soldernerd/UserInterface/UserInterface_RevB_BOM.xlsx

Qty | Value | Device | Package | Parts | Description
5 | 0R | RESISTORR0805 | R0805 | R4, R5, R6, R23, R24 | RESISTOR, European symbol
1 | 10R | RESISTORR0805 | R0805 | R8 | RESISTOR, European symbol
3 | 100k | RESISTORR0805 | R0805 | R16, R17, R18 | RESISTOR, European symbol
4 | 100n | CC0805 | C0805 | C2, C14, C15, C16 | Capacitor
7 | 10k | RESISTORR0805 | R0805 | R2, R3, R7, R9, R10, R11, R12 | RESISTOR, European symbol
3 | 10n | CC0805 | C0805 | C11, C12, C13 | Capacitor
2 | 10u | CC0805 | C0805 | C1, C10 | Capacitor
7 | 1u | CC0805 | C0805 | C3, C4, C5, C6, C7, C8, C9 | Capacitor
3 | 22k | RESISTORR0805 | R0805 | R13, R14, R15 | RESISTOR, European symbol
7 | 680k | RESISTORR0805 | R0805 | R1, R19, R20, R21, R22, R25, R26 | RESISTOR, European symbol
1 | 74HC126 | 74HC126 | SO14 | IC2 | Quad buffer/line driver; 3-state
1 | MCP4641 | MCP4641 | TSSOP14 | IC1 | Dual DigiPot with 128 steps and non-volatile memory
1 | MCP601R | MCP601R | SOT-23-5 | IC4 | Rail-to-Rail OpAmp (Marking SM07)
1 | MIDAS MCCOG42005A6W | LCD4X20_I2C | LCD_4X20_I2C | DISPLAY | 4x20 character LCD display with I2C interface
1 | NTR4101PT1G | P-FETSOT23 | SOT23 | Q2 | P-Channel MOSFET (Marking TR4)
1 | NX3008NBK | N-FETSOT23 | SOT23 | Q1 | N-Channel MOSFET (Marking KS)
1 | PEC11R | ENCODER_BOURNS | ENCODER_BOURNS | ENCODER | Bourns Rotary Encoder with Switch
