soldernerd/UserInterface/UserInterface_RevA_Schematic.pdf

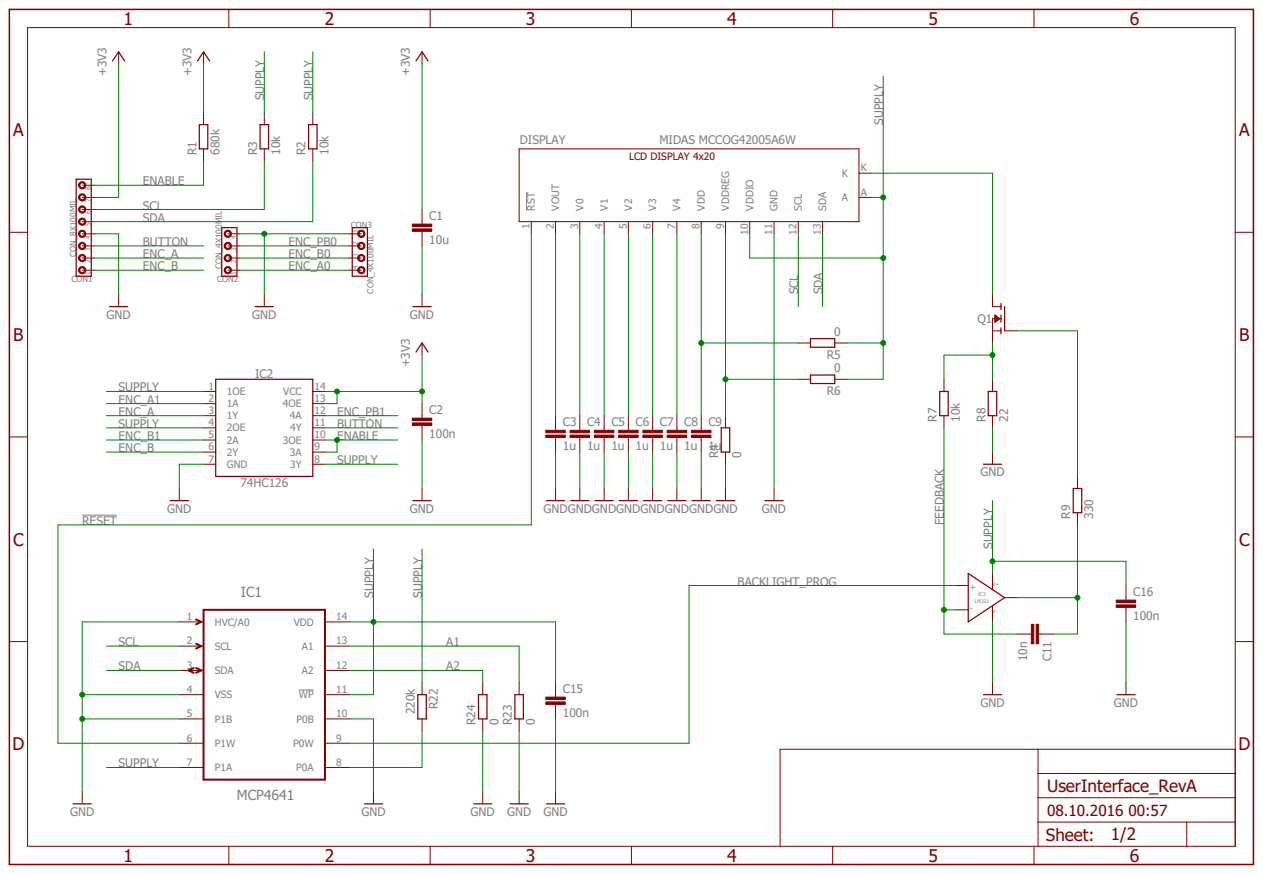
[picture p1: page 1]
