soldernerd/UserInterface/UserInterface_RevA_Board.pdf

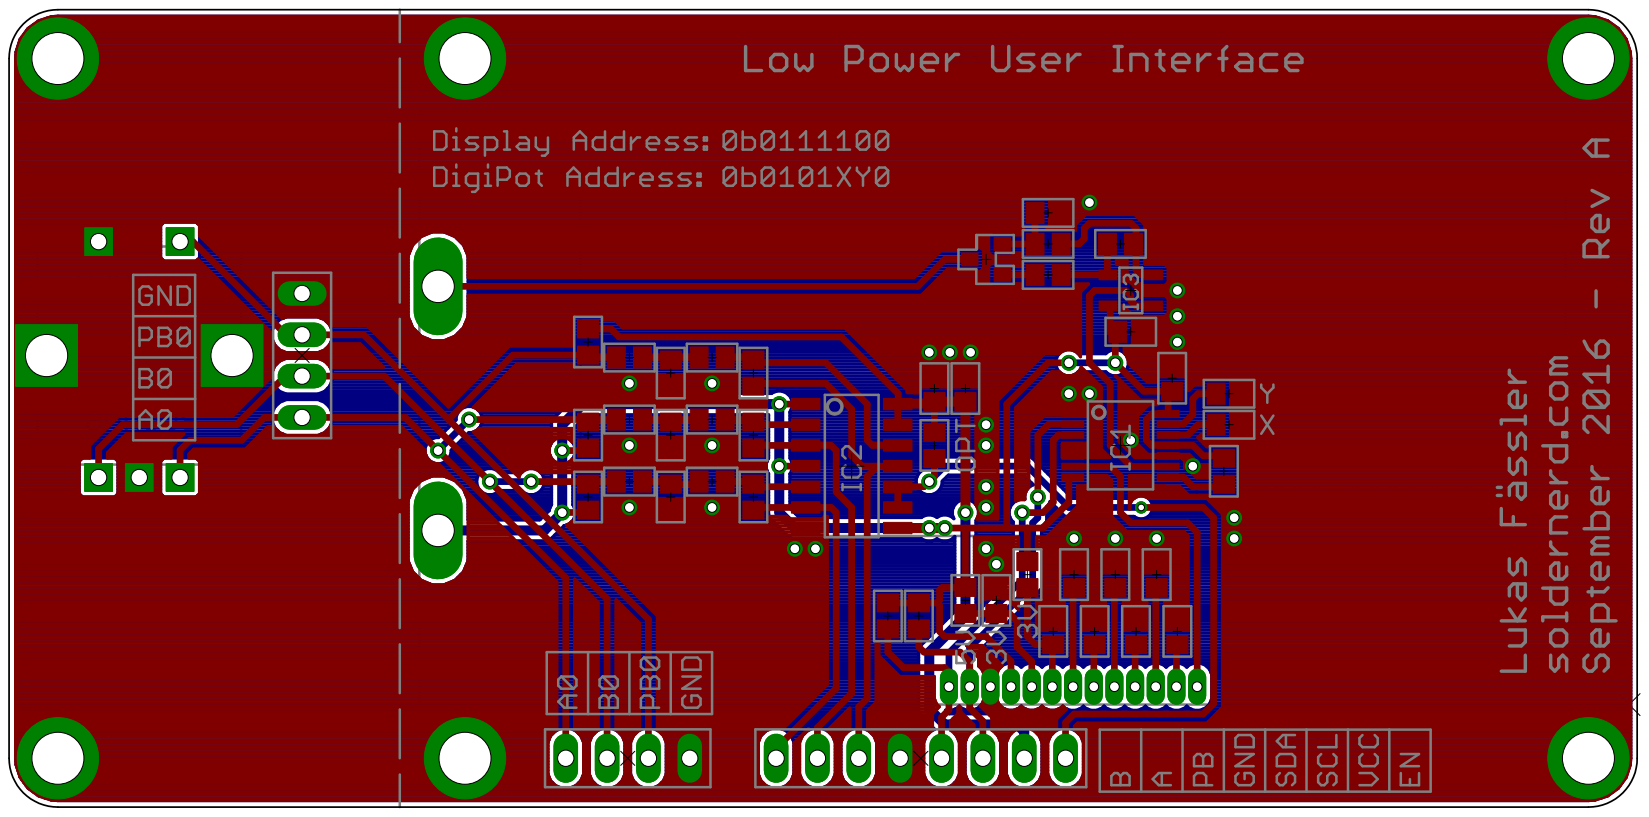
[picture p2: page 1]
