soldernerd/UserInterface/UserInterface_RevB.pdf

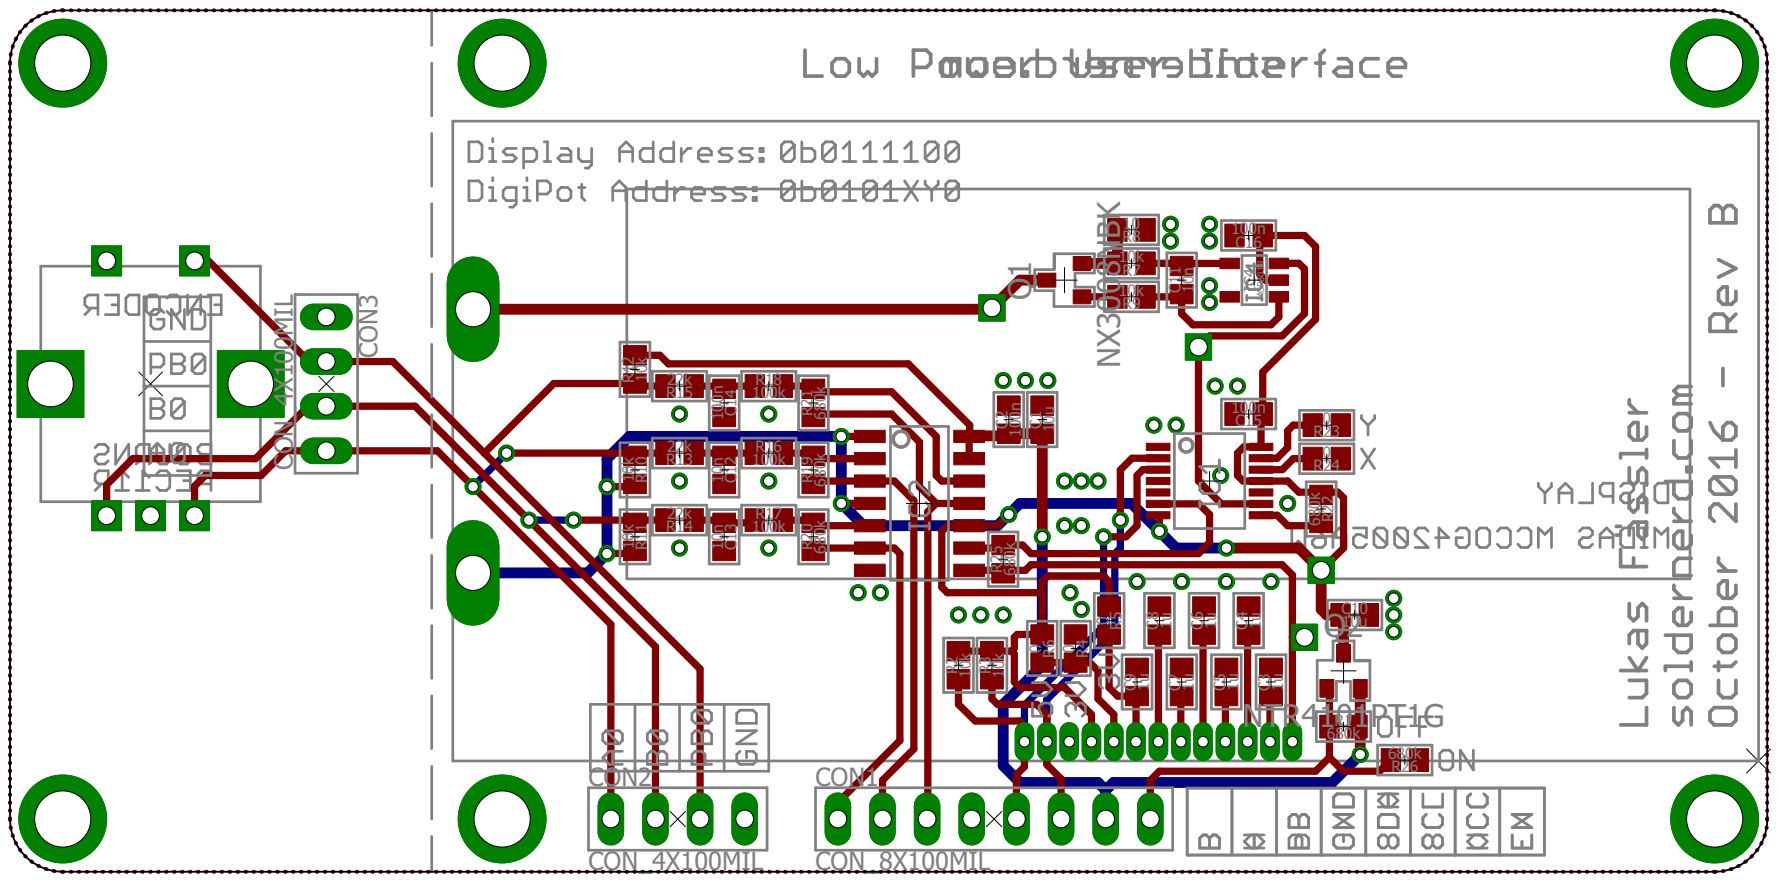
[picture p3: page 1]
