soldernerd/UserInterface/UserInterface_RevB.brd

## EAGLE design UserInterface_RevB.brd (2017-02-03, an earlier design)

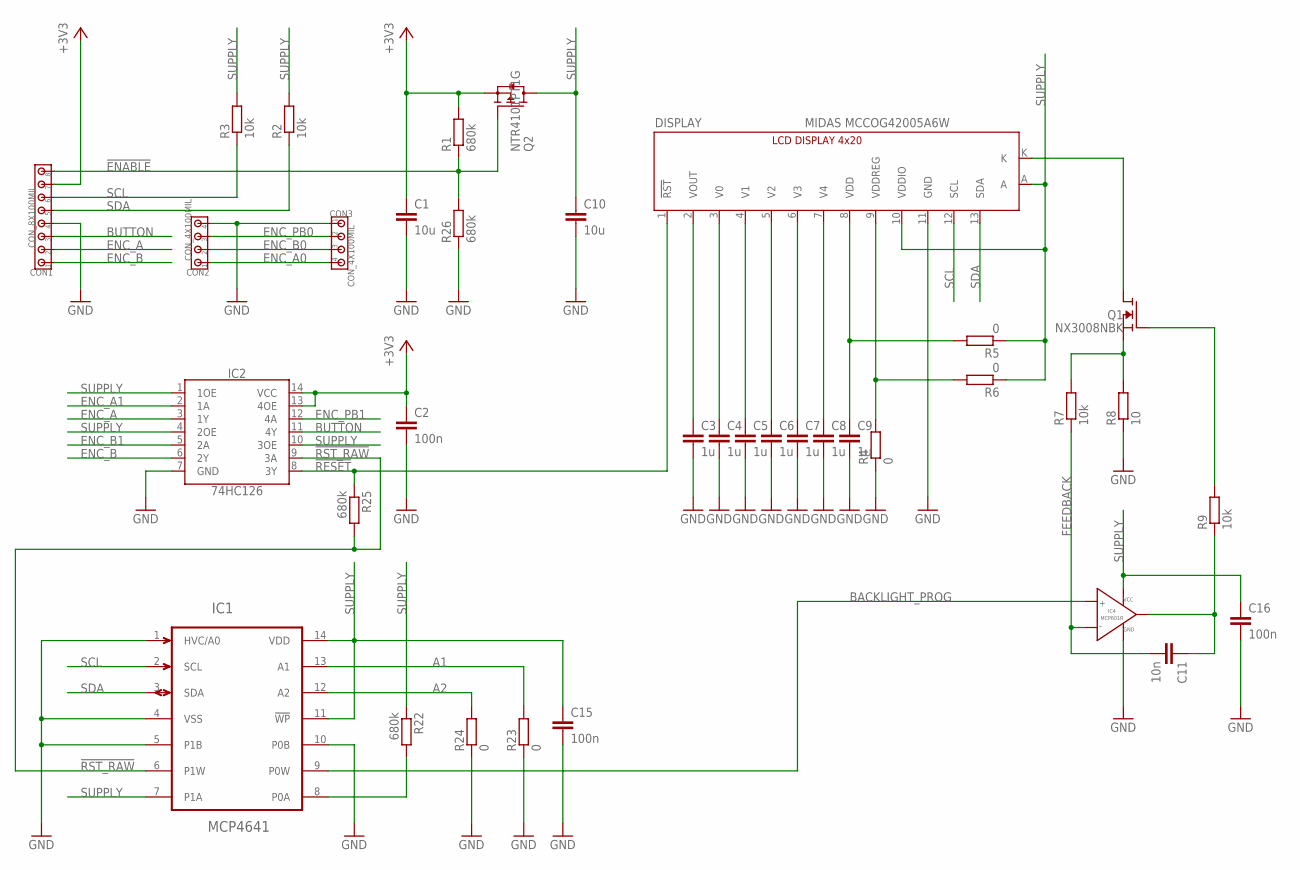
[picture p4: schematic UserInterface_RevB.sch, sheet 1]

Parts:
C1, C10: 10u; C0805
C2, C15, C16: 100n; C0805
C3, C4, C5, C6, C7, C8, C9: 1u; C0805
C11: 10n; C0805
CON1: CON_8X100MIL; 100MIL_8X
CON2, CON3: CON_4X100MIL; 100MIL_4X
DISPLAY: MIDAS MCCOG42005A6W; LCD_4X20_I2C
IC1: MCP4641; TSSOP14
IC2: 74HC126; SO14
IC4: MCP601R; SOT-23-5
Q1: NX3008NBK; SOT23
Q2: NTR4101PT1G; SOT23
R1, R22, R25, R26: 680k; R0805
R2, R3, R7, R9: 10k; R0805
R4, R5, R6, R23, R24: 0; R0805
R8: 10; R0805

Connections:
!ENABLE!: CON1.8, Q2.1 (G), R1.1, R26.2
!RESET!: DISPLAY.1 (!RST!), IC2.8 (3Y), R25.1
!RST_RAW!: IC1.6 (P1W), IC2.9 (3A), R25.2
+3V3: C1.1, C2.1, CON1.7, IC2.13 (4OE), IC2.14 (VCC), Q2.2 (S), R1.2; also elsewhere on the board
A1: IC1.13 (A1), R23.2
A2: IC1.12 (A2), R24.2
BACKLIGHT_PROG: IC1.9 (P0W), IC4.3 (VIN+)
BUTTON: CON1.3, IC2.11 (4Y); also elsewhere on the board
ENC_A: CON1.2, IC2.3 (1Y); also elsewhere on the board
ENC_A0: CON2.1, CON3.4; also elsewhere on the board
ENC_A1: IC2.2 (1A); also elsewhere on the board
ENC_B: CON1.1, IC2.6 (2Y); also elsewhere on the board
ENC_B0: CON2.2, CON3.3; also elsewhere on the board
ENC_B1: IC2.5 (2A); also elsewhere on the board
ENC_PB0: CON2.3, CON3.2; also elsewhere on the board
ENC_PB1: IC2.12 (4A); also elsewhere on the board
FEEDBACK: C11.2, IC4.4 (VIN-), R7.1
GND: C1.2, C2.2, C3.2, C4.2, C5.2, C6.2, C7.2, C8.2, C9.2, C10.2, C15.2, C16.2, CON1.4, CON2.4, CON3.1, DISPLAY.11 (GND), IC1.1 (HVC/A0), IC1.4 (VSS), IC1.5 (P1B), IC1.10 (P0B), IC2.7 (GND), IC4.5 (GND), R4.1, R8.1, R23.1, R24.1, R26.1; also elsewhere on the board
LED_K: DISPLAY.K, Q1.3 (D)
unnamed: C3.1, DISPLAY.2 (VOUT)
unnamed: C4.1, DISPLAY.3 (V0)
unnamed: C8.1, DISPLAY.7 (V4)
unnamed: C7.1, DISPLAY.6 (V3)
unnamed: C6.1, DISPLAY.5 (V2)
unnamed: C5.1, DISPLAY.4 (V1)
unnamed: C11.1, IC4.1 (VOUT), R9.1
unnamed: Q1.1 (G), R9.2
unnamed: Q1.2 (S), R7.2, R8.2
unnamed: IC1.8 (P0A), R22.2
SCL: CON1.6, DISPLAY.12 (SCL), IC1.2 (SCL), R3.1
SDA: CON1.5, DISPLAY.13 (SDA), IC1.3 (SDA), R2.1
SUPPLY: C10.1, C15.1, C16.1, DISPLAY.10 (VDDIO), DISPLAY.A, IC1.7 (P1A), IC1.11 (!WP!), IC1.14 (VDD), IC2.1 (1OE), IC2.4 (2OE), IC2.10 (3OE), IC4.2 (VCC), Q2.3 (D), R2.2, R3.2, R5.1, R6.1, R22.1; also elsewhere on the board
VDD: C9.1, DISPLAY.8 (VDD), R5.2
VDREG: DISPLAY.9 (VDDREG), R4.2, R6.2

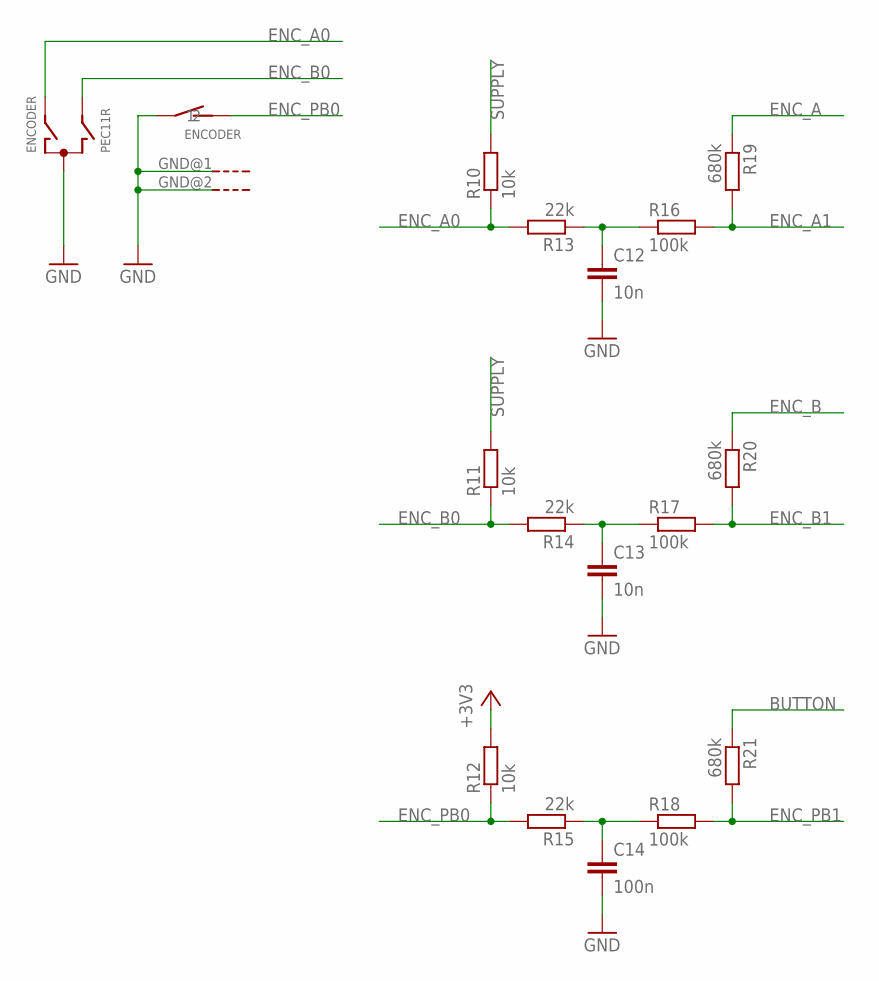
[picture p5: schematic UserInterface_RevB.sch, sheet 2]

Parts:
C12, C13: 10n; C0805
C14: 100n; C0805
ENCODER: PEC11R; ENCODER_BOURNS
R10, R11, R12: 10k; R0805
R13, R14, R15: 22k; R0805
R16, R17, R18: 100k; R0805
R19, R20, R21: 680k; R0805

Connections:
+3V3: R12.2; also elsewhere on the board
BUTTON: R21.1; also elsewhere on the board
ENC_A: R19.1; also elsewhere on the board
ENC_A0: ENCODER.A, R10.1, R13.2; also elsewhere on the board
ENC_A1: R16.2, R19.2; also elsewhere on the board
ENC_B: R20.1; also elsewhere on the board
ENC_B0: ENCODER.B, R11.1, R14.2; also elsewhere on the board
ENC_B1: R17.2, R20.2; also elsewhere on the board
ENC_PB0: ENCODER.1, R12.1, R15.2; also elsewhere on the board
ENC_PB1: R18.2, R21.2; also elsewhere on the board
GND: C12.2, C13.2, C14.2, ENCODER.2, ENCODER.C, ENCODER.GND@1 (G), ENCODER.GND@2 (G); also elsewhere on the board
unnamed: C13.1, R14.1, R17.1
unnamed: C12.1, R13.1, R16.1
unnamed: C14.1, R15.1, R18.1
SUPPLY: R10.2, R11.2; also elsewhere on the board

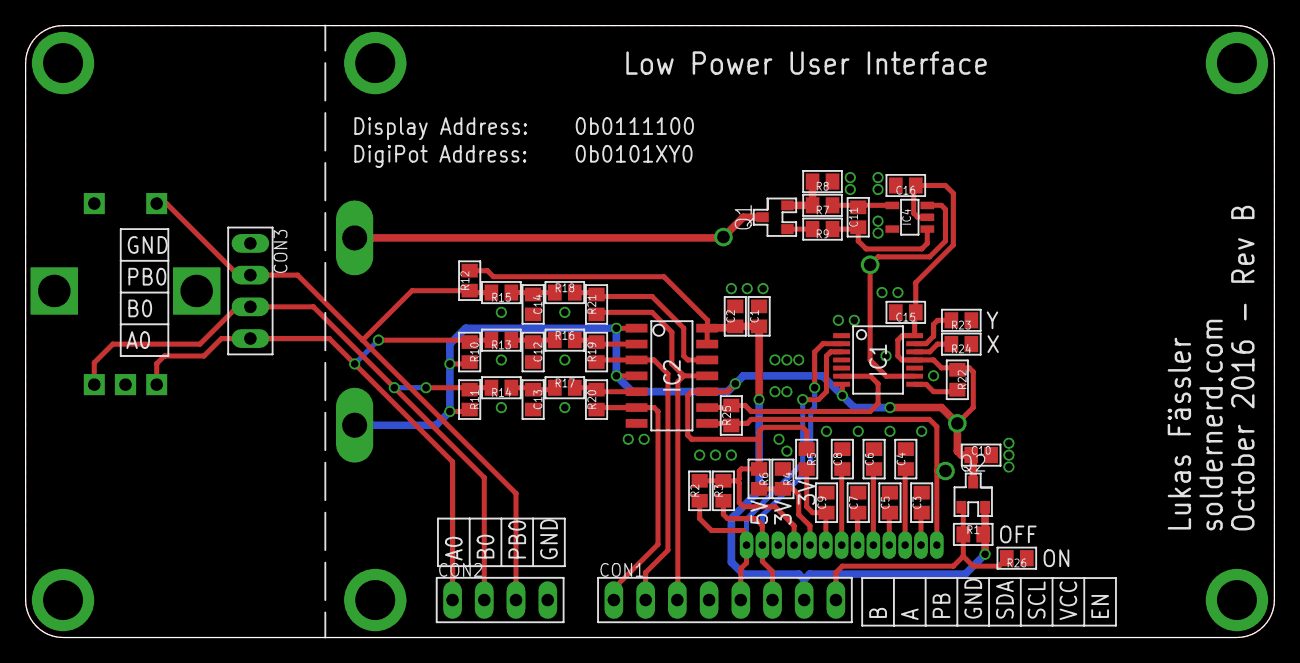
[picture p6: board UserInterface_RevB.brd from above]

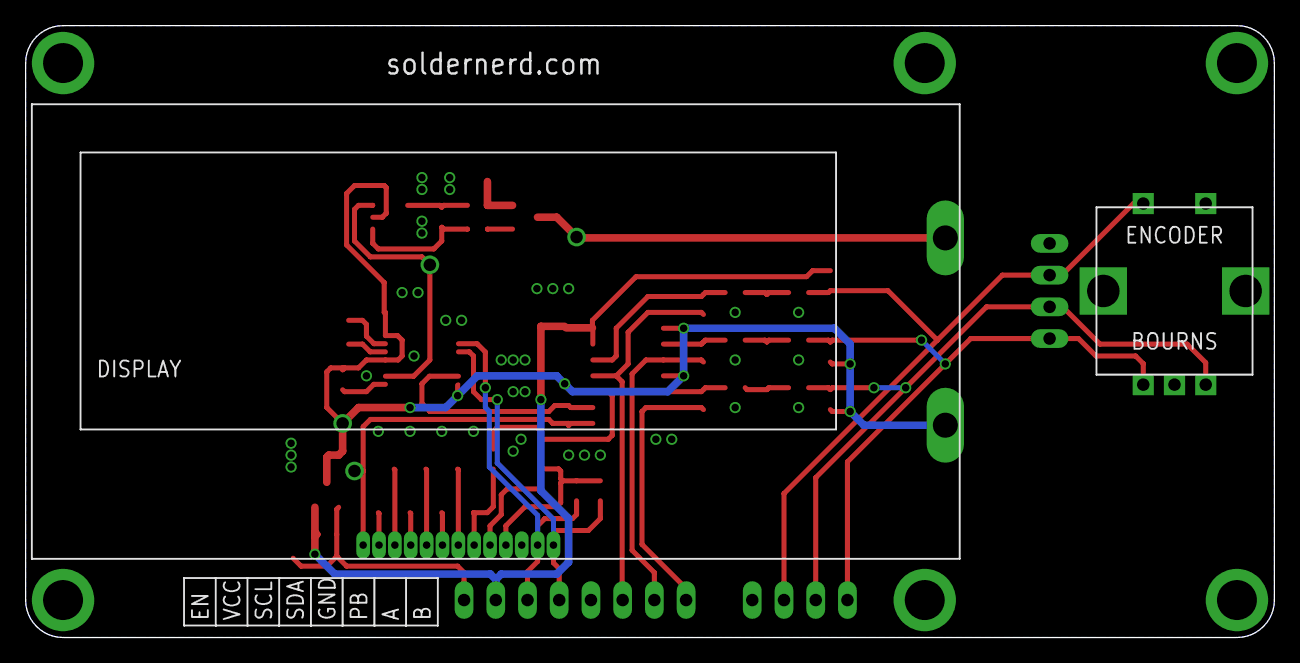
[picture p7: board UserInterface_RevB.brd from below]

Board: 2 copper layers, 100.0 x 49.0 mm, 52 parts (2 on the bottom side), 37 nets.
